DangerousElectrician/SmarterCopter/README

better brains for a syma 107 toy helicopter

Stuff to fix:
Holes are spaced back to front. Hole sizes are fine
U2 grounding pad covered by soldermask
Mousebites need to be sanded flat
