DangerousElectrician/SmarterCopter/(list of files, drawings)

Other design files:
cad/smartercopter.dsn
