DangerousElectrician/SmarterCopter/cad/smartercopter.kicad_pcb

## KiCad design cad/smartercopter.kicad_pcb (2015-04-01)

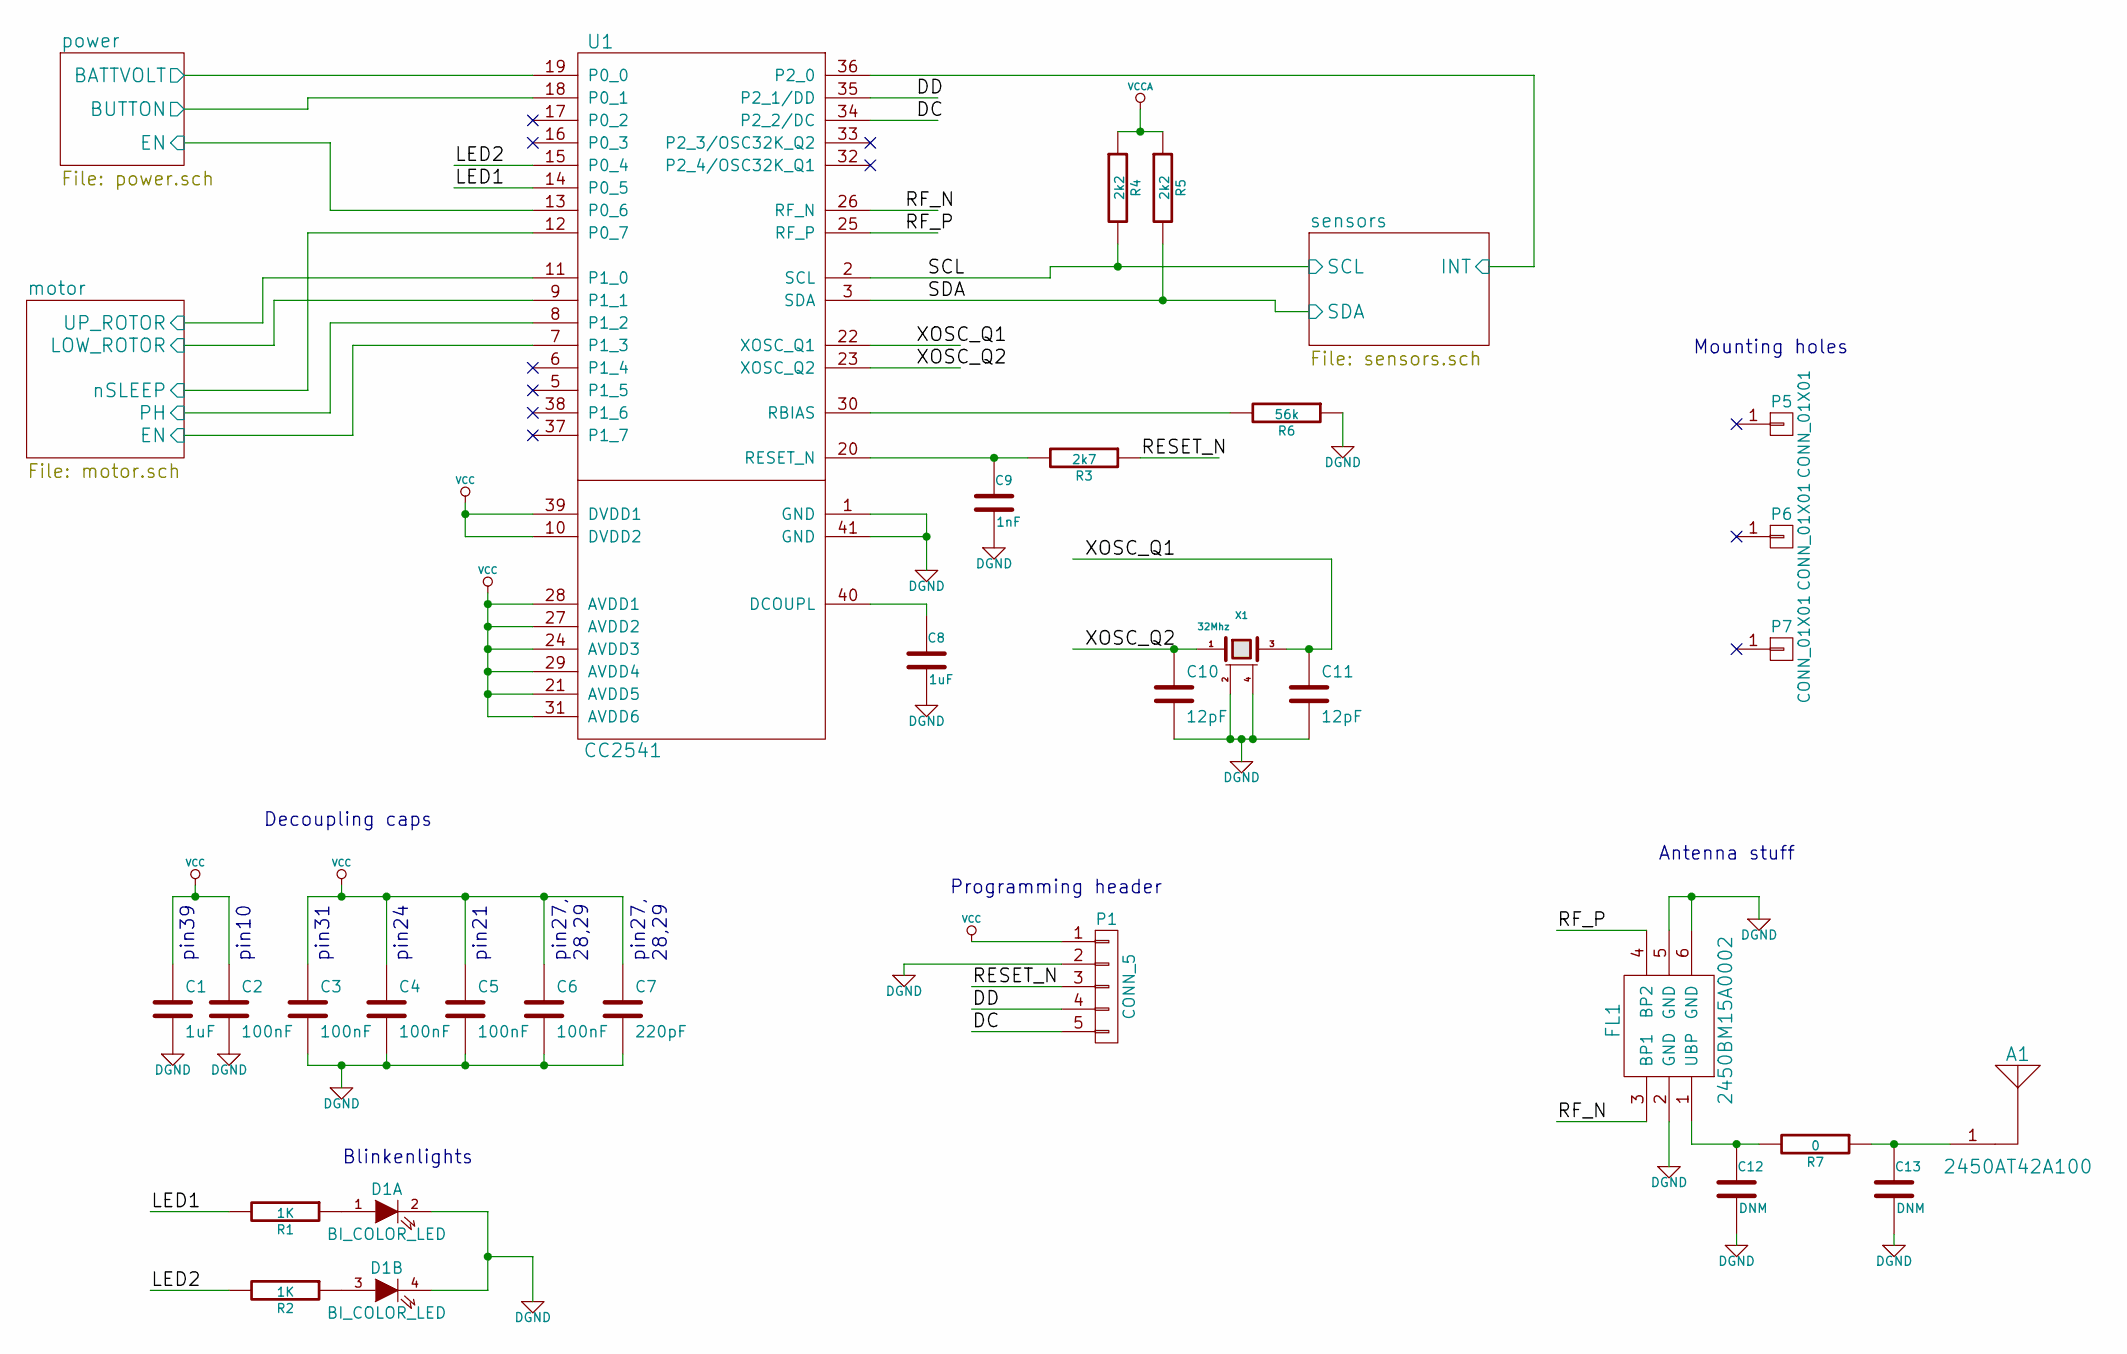
[picture p4: schematic smartercopter.sch]

Parts:
A1: 2450AT42A100; MPN 2450AT42A100
C1: 1uF; C_0402; MPN GRM155R60J105KE19D
C2: 100nF; C_0402; MPN LMK105BJ104KV-F
C3, C4, C5, C6: 100nF; C_0402
C7: 220pF; C_0402; MPN CC0402KRX7R9BB221
C8: 1uF; C_0402
C9: 1nF; C_0402; MPN GRM155R71H102KA01D
C10: 12pF; C_0201; MPN 02013A120JAT2A
C11: 12pF; C_0201
C12, C13: DNM; C_0402
D1: BI_COLOR_LED; APTB1612ESGC-F01; MPN APTB1612ESGC-F01
FL1: 2450BM15A0002; MPN 2450BM15A0002
P1: CONN_5; pin_array_1x05
P5, P6, P7: CONN_01X01; MountingHole_3mm
R1: 1K; R_0402; MPN 1-1622826-8
R2: 1K; R_0402
R3: 2k7; R_0402; MPN RMCF0402JT2K70
R4, R5: 2k2; R_0402
R6: 56k; R_0402; MPN MCR01MRTF5602
R7: 0; R_0402
U1: CC2541; VQFN-40; MPN CC2541F256RHAR
X1: 32Mhz; 4-SMD; MPN FA-128 32.0000MF20X-K3

Connections:
/DC: P1.5, U1.34 (P2_2/DC)
/DD: P1.4, U1.35 (P2_1/DD)
/LED1: R1.2, U1.14 (P0_5)
/LED2: R2.2, U1.15 (P0_4)
/RESET_N: P1.3, R3.1
/RF_N: FL1.3 (BP1), U1.26 (RF_N)
/RF_P: FL1.4 (BP2), U1.25 (RF_P)
/XOSC_Q1: C11.1, U1.22 (XOSC_Q1), X1.3
/XOSC_Q2: C10.1, U1.23 (XOSC_Q2), X1.1
/motor/EN: U1.7 (P1_3); also elsewhere on the board
/motor/LOW_ROTOR: U1.9 (P1_1); also elsewhere on the board
/motor/PH: U1.8 (P1_2); also elsewhere on the board
/motor/UP_ROTOR: U1.11 (P1_0); also elsewhere on the board
/motor/nSLEEP: U1.12 (P0_7); also elsewhere on the board
/power/BATTVOLT: U1.19 (P0_0); also elsewhere on the board
/power/BUTTON: U1.18 (P0_1); also elsewhere on the board
/power/EN: U1.13 (P0_6); also elsewhere on the board
/sensors/INT: U1.36 (P2_0); also elsewhere on the board
/sensors/SCL: R4.2, U1.2 (SCL); also elsewhere on the board
/sensors/SDA: R5.2, U1.3 (SDA); also elsewhere on the board
DGND: C1.2, C2.2, C3.2, C4.2, C5.2, C6.2, C7.2, C8.2, C9.2, C10.2, C11.2, C12.2, C13.2, D1.2 (K), D1.4 (K), FL1.2 (GND), FL1.5 (GND), FL1.6 (GND), P1.2, R6.1, U1.1 (GND), U1.41 (GND), X1.2 (GND), X1.4 (GND); also elsewhere on the board
unnamed: A1.1, C13.1, R7.1
unnamed: C8.1, U1.40 (DCOUPL)
unnamed: C9.1, R3.2, U1.20 (RESET_N)
unnamed: C12.1, FL1.1 (UBP), R7.2
unnamed: D1.1 (A), R1.1
unnamed: D1.3 (A), R2.1
unnamed: R6.2, U1.30 (RBIAS)
VCC: C1.1, C2.1, C3.1, C4.1, C5.1, C6.1, C7.1, P1.1, U1.10 (DVDD2), U1.21 (AVDD5), U1.24 (AVDD3), U1.27 (AVDD2), U1.28 (AVDD1), U1.29 (AVDD4), U1.31 (AVDD6), U1.39 (DVDD1); also elsewhere on the board
VCCA: R4.1, R5.1; also elsewhere on the board

Notes on the sheet:
pin39
pin10
pin31
pin24
pin21
pin27, 28,29
Blinkenlights
Antenna stuff
Programming header
Decoupling caps
Mounting holes

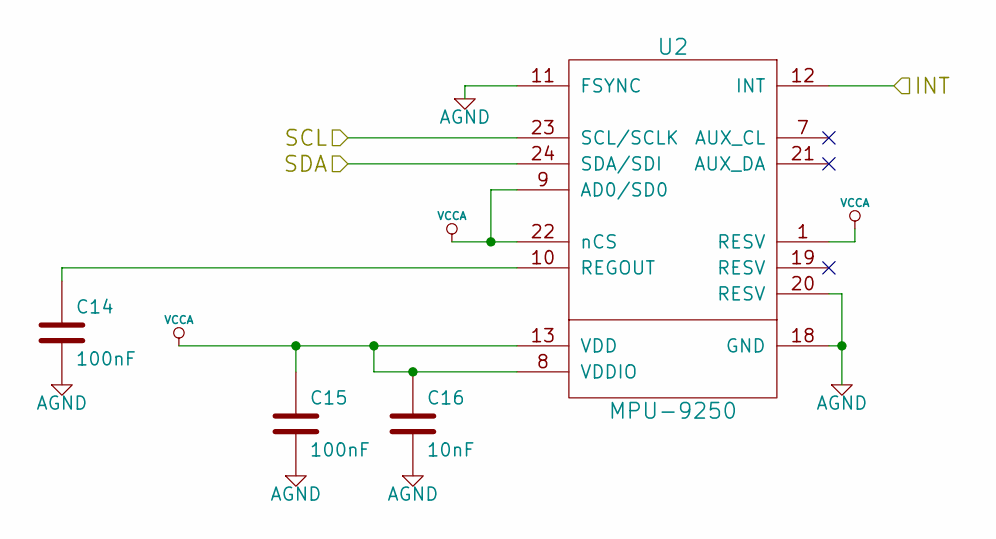
[picture p5: schematic sensors.sch]

Parts:
C14, C15: 100nF; C_0402
C16: 10nF; C_0402; MPN GRM155R71E103KA01D
U2: MPU-9250; QFN-28-1EP; MPN MPU-9250

Connections:
/sensors/INT: U2.12 (INT); also elsewhere on the board
/sensors/SCL: U2.23 (SCL/SCLK); also elsewhere on the board
/sensors/SDA: U2.24 (SDA/SDI); also elsewhere on the board
AGND: C14.2, C15.2, C16.2, U2.11 (FSYNC), U2.18 (GND), U2.20 (RESV); also elsewhere on the board
unnamed: C14.1, U2.10 (REGOUT)
VCCA: C15.1, C16.1, U2.1 (RESV), U2.8 (VDDIO), U2.9 (AD0/SD0), U2.13 (VDD), U2.22 (nCS); also elsewhere on the board

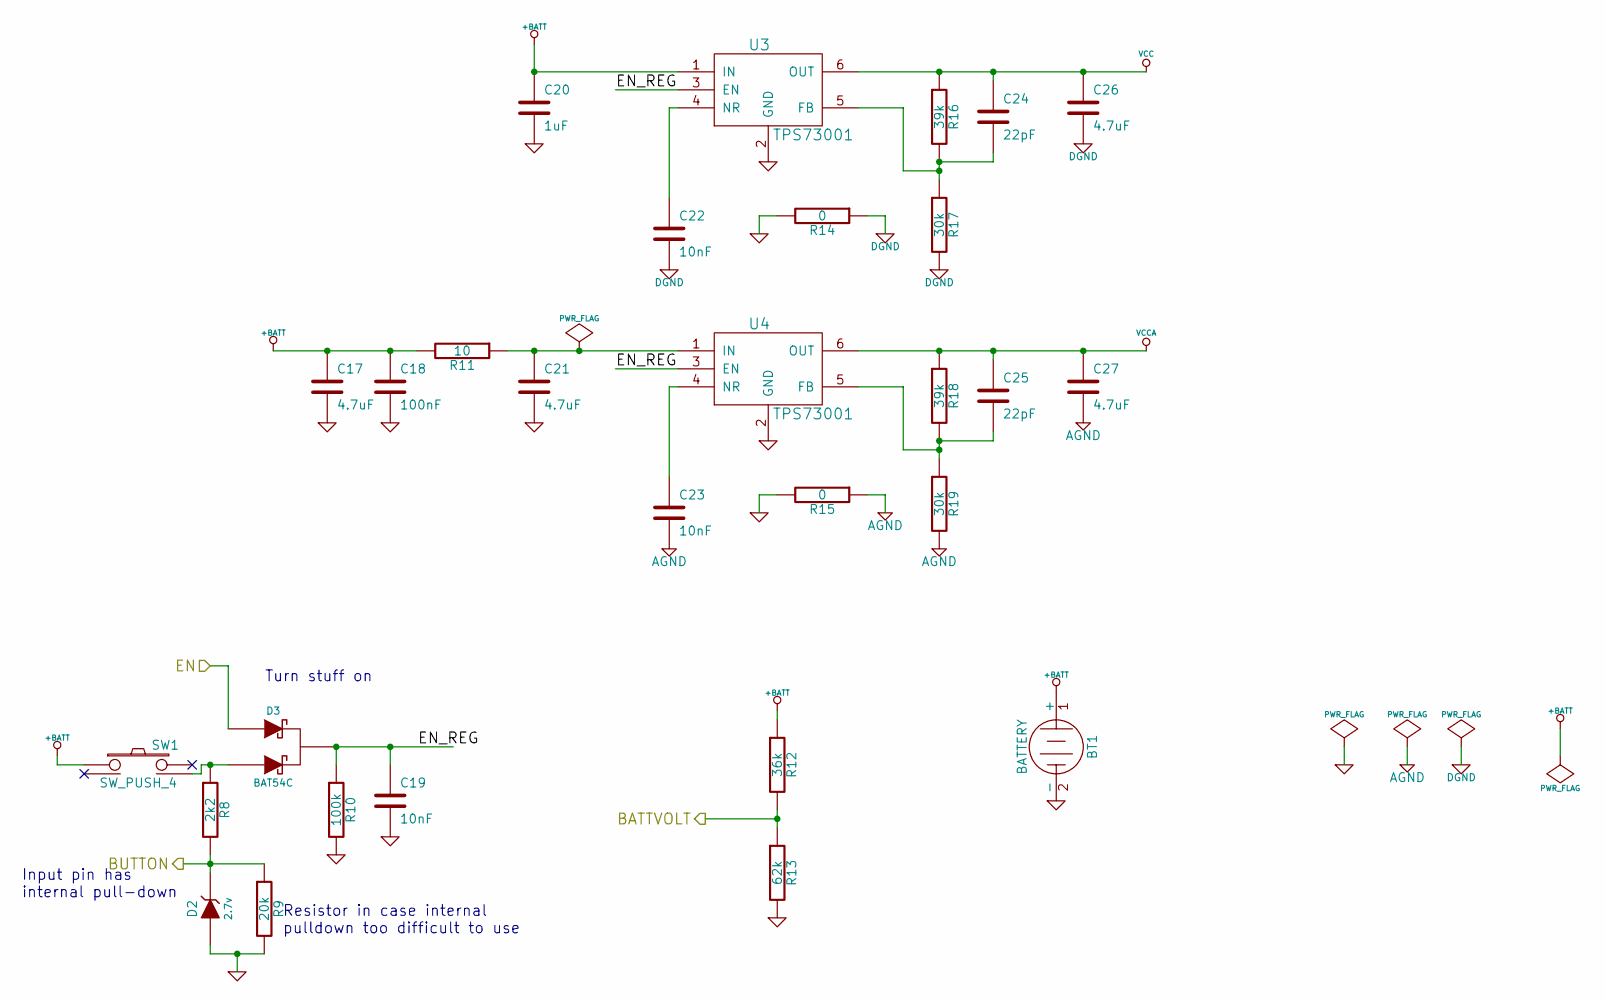
[picture p6: schematic power.sch]

Parts:
BT1: BATTERY; Pin_Header_Straight_1x02
C17, C21, C27: 4.7uF; C_0603
C18: 100nF; C_0402
C19, C22, C23: 10nF; C_0402
C20: 1uF; C_0402
C24: 22pF; C_0402; MPN CL05C220JB5NNNC
C25: 22pF; C_0402
C26: 4.7uF; C_0603; MPN CL10B475KQ8NQNC
D2: 2.7v; SOD-323; MPN MM3Z2V7T1G
D3: BAT54C; Diode_SOT23
R8: 2k2; R_0402; MPN RMCF0402JT2K20
R9: 20k; R_0402; MPN MCR01MRTF2002
R10: 100k; R_0402; MPN MCR01MRTF1003
R11: 10; R_0402; MPN MCR01MRTF10R0
R12: 36k; R_0402; MPN MCR01MRTF3602
R13: 62k; R_0402; MPN MCR01MRTJ623
R14: 0; R_0402; MPN RC1005J000CS
R15: 0; R_0402
R16: 39k; R_0402; MPN RC1005J393CS
R17: 30k; R_0402; MPN RC1005J303CS
R18: 39k; R_0402
R19: 30k; R_0402
SW1: SW_PUSH_4; PTS840GMSMTRLFS; MPN PTS840 GM SMTR LFS
U3: TPS73001; SOT-23-6; MPN TPS73001DBVR
U4: TPS73001; SOT-23-6

Connections:
+BATT: BT1.1 (+), C17.1, C18.1, C20.1, R11.2, R12.1, SW1.1, U3.1 (IN); also elsewhere on the board
/power/BATTVOLT: R12.2, R13.1; also elsewhere on the board
/power/BUTTON: D2.2 (K), R8.2, R9.1; also elsewhere on the board
/power/EN: D3.1; also elsewhere on the board
/power/EN_REG: C19.1, D3.3, R10.1, U3.3 (EN), U4.3 (EN)
AGND: C23.2, C27.2, R15.1, R19.2; also elsewhere on the board
DGND: C22.2, C26.2, R14.1, R17.2; also elsewhere on the board
GND: BT1.2 (-), C17.2, C18.2, C19.2, C20.2, C21.2, D2.1 (A), R9.2, R10.2, R13.2, R14.2, R15.2, U3.2 (GND), U4.2 (GND); also elsewhere on the board
unnamed: C21.1, R11.1, U4.1 (IN)
unnamed: C22.1, U3.4 (NR)
unnamed: C23.1, U4.4 (NR)
unnamed: C24.2, R16.2, R17.1, U3.5 (FB)
unnamed: C25.2, R18.2, R19.1, U4.5 (FB)
unnamed: D3.2, R8.1, SW1.4
VCC: C24.1, C26.1, R16.1, U3.6 (OUT); also elsewhere on the board
VCCA: C25.1, C27.1, R18.1, U4.6 (OUT); also elsewhere on the board

Notes on the sheet:
Input pin has internal pull-down
Resistor in case internal pulldown too difficult to use
Turn stuff on

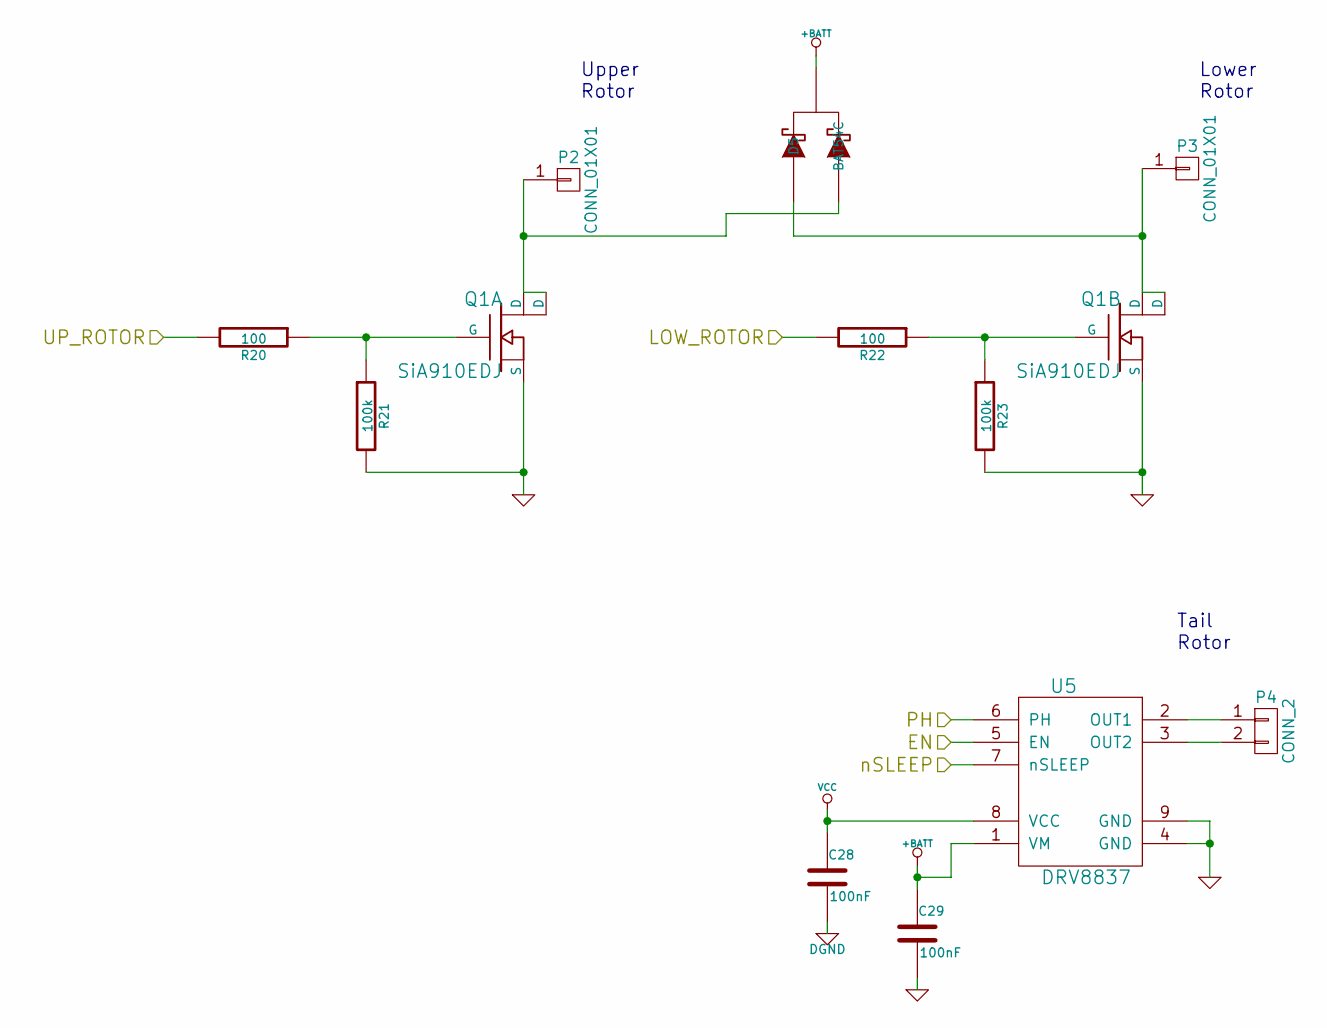
[picture p7: schematic motor.sch]

Parts:
C28, C29: 100nF; C_0402
D5: BAT54C; Diode_SOT23; MPN BAT54C
P2, P3: CONN_01X01; Pin_Header_Straight_1x01
P4: CONN_2; Pin_Header_Straight_1x02
Q1: SiA910EDJ; SC-70-6L; MPN SIA910EDJ-T1-GE3
R20: 100; R_0402; MPN MCR01MRTF1000
R21, R23: 100k; R_0402
R22: 100; R_0402
U5: DRV8837; WSON-8-1EP; MPN DRV8837DSGR

Connections:
+BATT: C29.1, D5.3, U5.1 (VM); also elsewhere on the board
/motor/EN: U5.5 (EN); also elsewhere on the board
/motor/LOW_ROTOR: R22.2; also elsewhere on the board
/motor/PH: U5.6 (PH); also elsewhere on the board
/motor/UP_ROTOR: R20.2; also elsewhere on the board
/motor/nSLEEP: U5.7 (nSLEEP); also elsewhere on the board
DGND: C28.2; also elsewhere on the board
GND: C29.2, Q1.1 (S), Q1.4 (S), R21.2, R23.2, U5.4 (GND), U5.9 (GND); also elsewhere on the board
unnamed: D5.1, P3.1, Q1.3 (D), Q1.D2 (D)
unnamed: D5.2, P2.1, Q1.6 (D), Q1.D1 (D)
unnamed: P4.1, U5.2 (OUT1)
unnamed: P4.2, U5.3 (OUT2)
unnamed: Q1.2 (G), R20.1, R21.1
unnamed: Q1.5 (G), R22.1, R23.1
VCC: C28.1, U5.8 (VCC); also elsewhere on the board

Notes on the sheet:
Upper Rotor
Lower Rotor
Tail Rotor

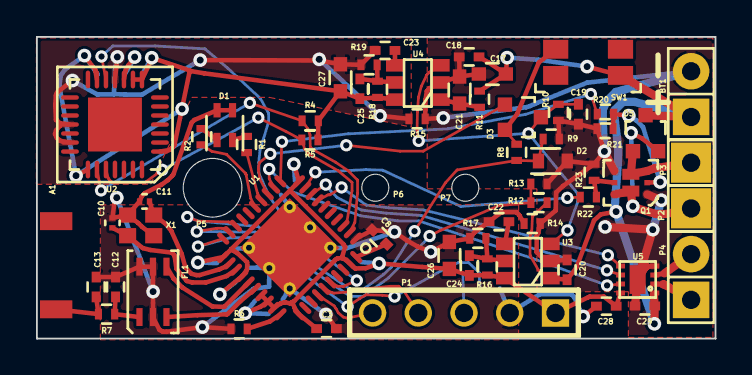
[picture p8: board smartercopter.kicad_pcb from above]

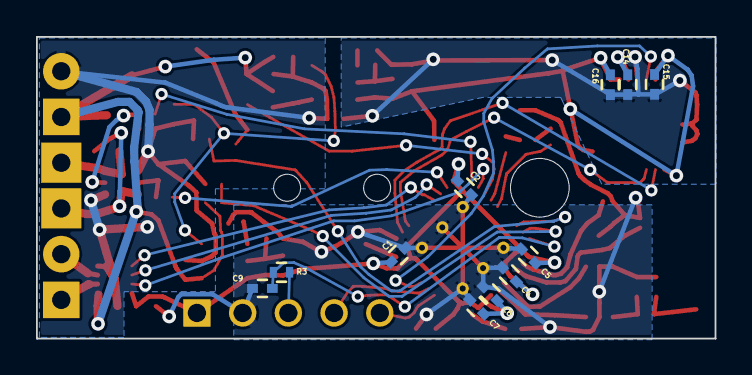
[picture p9: board smartercopter.kicad_pcb from below]

Board: 2 copper layers, 37.7 x 16.8 mm, 74 parts (11 on the bottom side), 47 nets.
