DangerousElectrician/SmarterCopter/(commit log)

2014-12-08 added more sensor and processor considerations
2014-12-09 more stuff about sensors
2014-12-09 considering another sensor
2014-12-10 added requirements at top and a bit more information on sensors and motor drive
2014-12-10 figured out power requirements of CC2541 and MPU9250
2014-12-10 added some voltage regulator details
2014-12-11 added soft power switch pins to pin list
2014-12-11 added stuff about flyback diodes
2014-12-12 added soft power switch information
2014-12-14 changed voltage regulator
2014-12-17 schematics and datasheets
    [motor.sch, power.sch, sensors.sch, smartercopter.sch]
2014-12-17 added values to crystal load caps
    [motor.sch, power.sch, sensors.sch, smartercopter.sch]
2014-12-17 passed erc
    [motor.sch, power.sch, sensors.sch, smartercopter.sch]
2014-12-18 something required to generate a BOM. not quite sure what it does
2014-12-18 did stuff here, not exactly sure what
    [motor.sch, power.sch, smartercopter.sch]
2014-12-18 added more stuff to bom
    [smartercopter.csv, smartercopter.sch]
2014-12-18 selecting parts for the little passives
    [motor.sch, power.sch, sensors.sch, smartercopter.csv, smartercopter.sch]
2014-12-19 whole bunch of stuff
    [motor.sch, power.sch, sensors.sch, smartercopter.csv, smartercopter.sch]
2014-12-19 more stuff
    [motor.sch, power.sch]
2014-12-20 updated BOM
    [smartercopter.csv]
2014-12-21 pcb file
    [smartercopter.kicad_pcb]
2014-12-21 added more footprint stuff
    [motor.sch, power.sch, sensors.sch, smartercopter.sch]
2014-12-22 bunch more footprints assigned
    [motor.sch, power.sch, sensors.sch, smartercopter.csv, smartercopter.sch]
2014-12-22 everything has a footprint
    [motor.sch, power.sch, smartercopter.csv, smartercopter.sch]
2014-12-22 all components spread out on sheet
    [smartercopter.kicad_pcb]
2014-12-22 found out decoupling caps are not connected in the net
    [smartercopter.kicad_pcb, smartercopter.sch]
2014-12-23 arranged stuff into smaller groups
    [smartercopter.kicad_pcb]
2014-12-23 components packed closer
    [smartercopter.kicad_pcb, smartercopter.sch]
2014-12-23 board outline
    [smartercopter.kicad_pcb]
2014-12-23 added board outline
    [smartercopter.kicad_pcb, smartercopter.sch]
2014-12-23 made motor pads single to save space
    [motor.sch, smartercopter.kicad_pcb, smartercopter.sch]
2014-12-24 packed most of the components on to board
    [smartercopter.kicad_pcb]
2014-12-24 everything on board
    [smartercopter.csv, smartercopter.kicad_pcb]
2014-12-24 routing first, then placing
    [smartercopter.kicad_pcb]
2014-12-24 routed voltage regulators
    [smartercopter.kicad_pcb]
2014-12-25 routed some stuff
    [motor.sch, smartercopter.kicad_pcb]
2014-12-26 stuff on board with a bit of routing
    [smartercopter.kicad_pcb]
2014-12-26 stuff on board
    [smartercopter.kicad_pcb]
2014-12-27 progress check in
    [power.sch, smartercopter.kicad_pcb, smartercopter.sch]
2014-12-27 freerouting stuff
    [smartercopter.dsn]
2014-12-28 more routing
    [smartercopter.kicad_pcb]
2014-12-30 components placed again
    [power.sch, smartercopter.dsn, smartercopter.kicad_pcb]
2014-12-30 freerouting files
    [smartercopter.kicad_pcb]
2015-01-01 everything routed
    [smartercopter.dsn, smartercopter.kicad_pcb, smartercopter.sch]
2015-01-02 everything routed for sure this time
    [smartercopter.dsn, smartercopter.kicad_pcb]
2015-01-02 no drc errors
    [smartercopter.dsn, smartercopter.kicad_pcb]
2015-01-02 added some ground planes
    [smartercopter.dsn, smartercopter.kicad_pcb]
2015-01-05 more power planes
    [smartercopter.dsn, smartercopter.kicad_pcb]
2015-01-11 double checking qfn-40 footprint
    [smartercopter.dsn, smartercopter.kicad_pcb, smartercopter.sch]
2015-01-15 changed cc2451 footprint center pad
    [smartercopter.dsn, smartercopter.kicad_pcb, smartercopter.sch]
2015-01-17 all routed
    [smartercopter.dsn, smartercopter.kicad_pcb]
2015-01-18 added ground planes
    [smartercopter.kicad_pcb]
2015-01-18 changed ground plane clearences
    [smartercopter.kicad_pcb]
2015-02-05 figured out how to change text dimensions from script
    [smartercopter.kicad_pcb]
2015-02-05 shrank all the silkscreen references
    [mod_smartercopter.kicad_pcb]
2015-02-06 moved references around
    [mod_smartercopter.kicad_pcb]
2015-02-06 renamed files
    [mod_smartercopter.kicad_pcb, smartercopter.kicad_pcb]
2015-02-07 increased soldermask clearance from 0 to 3mil
    [smartercopter.kicad_pcb]
2015-02-07 rerouted traces near the edge
    [smartercopter.dsn, smartercopter.kicad_pcb]
2015-02-07 changed some 3d footprints
    [smartercopter.kicad_pcb]
2015-02-07 generated gerbers
    [smartercopter-B_Cu.gbl, smartercopter-B_Mask.gbs, smartercopter-B_SilkS.gbo, smartercopter-Edge_Cuts.gbr, smartercopter-F_Cu.gtl, smartercopter-F_Mask.gts, smartercopter-F_SilkS.gto, smartercopter-NPTH.drl]
2015-02-07 ignore zipped gerbers
2015-03-05 regenerate bom, nothing changed really
    [smartercopter.csv]
2015-04-01 hid all value text
    [smartercopter.kicad_pcb]
2015-04-02 created assembly reference materials and organized directory a little
    [bom.ods]
